T-Vale/Ekrano/Images/2015-05-15 12.08.28.jpg

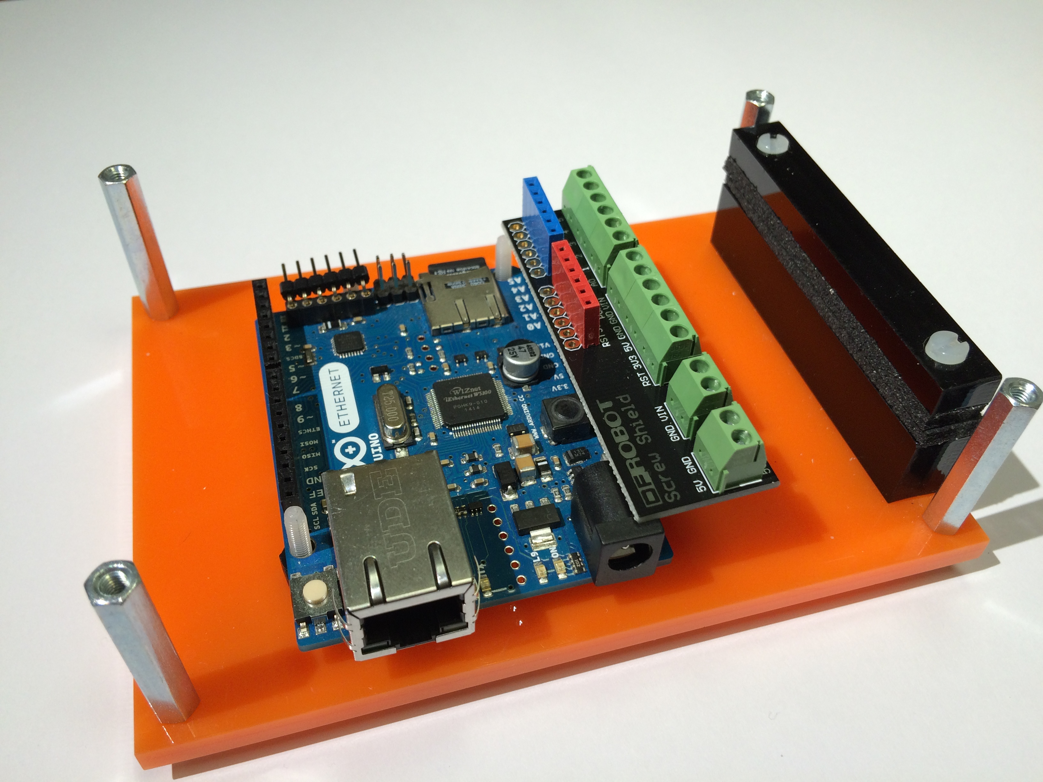
Images/2015-05-15 12.08.28.jpg
