T-Vale/Ekrano/Images/2015-05-15 12.07.00.jpg

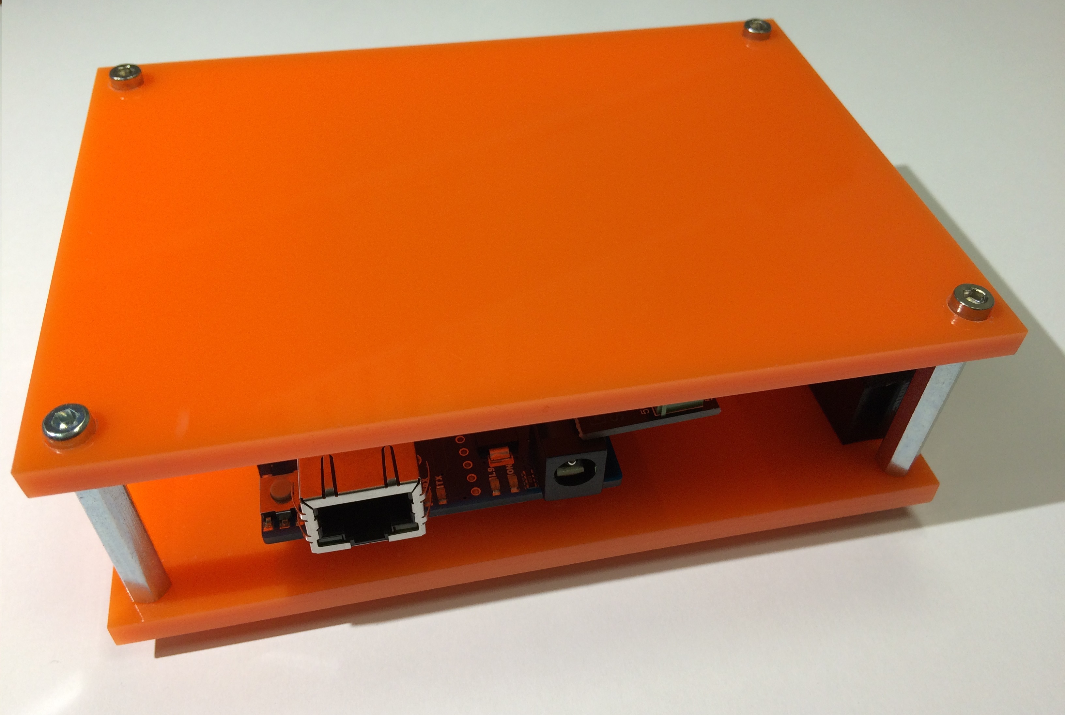
Images/2015-05-15 12.07.00.jpg
