T-Vale/Ekrano/SD Card Files/cinfo.txt

192.168.061.253;7500;90-A2-DA-0F-9F-1A;192.168.061.057;192.168.061.254;192.168.061.254
