T-Vale/Ekrano/Images/2015-05-15 12.06.43.jpg

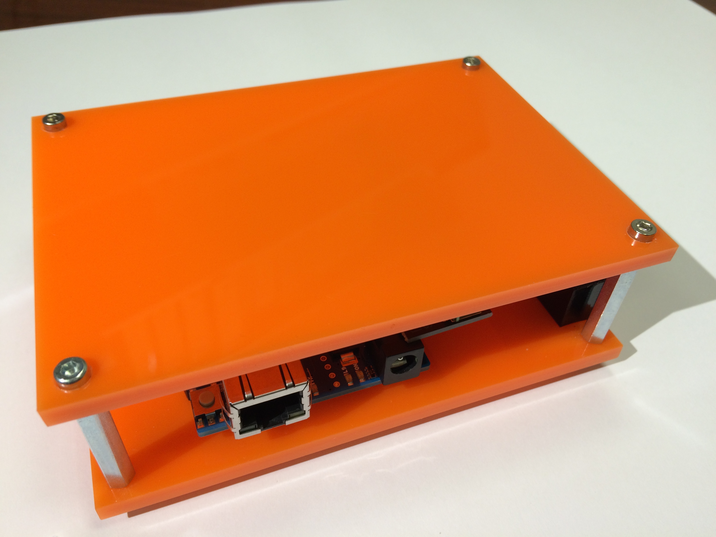
Images/2015-05-15 12.06.43.jpg
