T-Vale/Ekrano/Images/2015-05-15 12.06.49.jpg

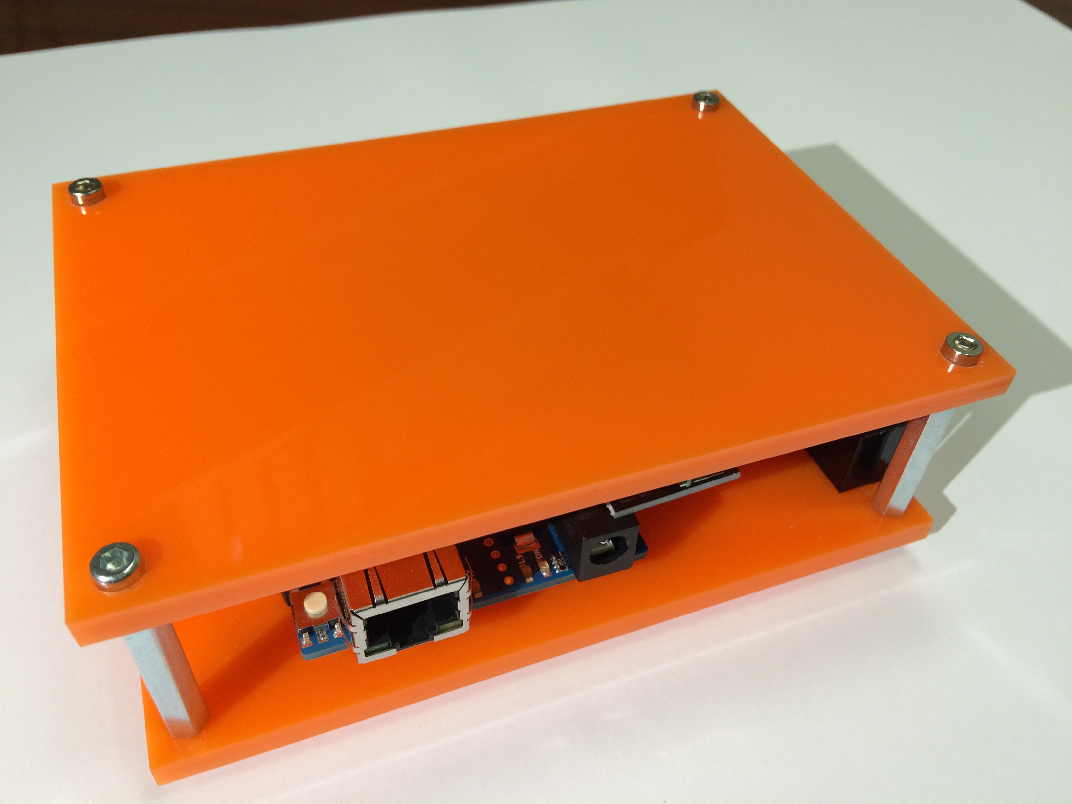
Images/2015-05-15 12.06.49.jpg
